david-rodriguez-blanco/SENSOR_VIPV/Sensor_VIPV_V5_SD/README.md

# SENSOR VIPV_V4
Trabajo Final de Grado: "Sensor IoT para la integración de generación fotovoltaica en vehículos eléctricos": 

Versión 4 - Mejoras: 
	· Concatenación de datos (obtención de datos con una frecuencia de 1s)
	· 2 nuevos canales de Thingspeak
	· Opción para publicación de datos concatenados (concatena datos cada 1s)
	· Opción para almacenar los datos en memoria SD y no depender de la conexión WiFi

	Proyecto desarrollado por David Rodríguez Blanco - UPM - IES
