david-rodriguez-blanco/SENSOR_VIPV/Modelos3D/Sensor_Sup.stl

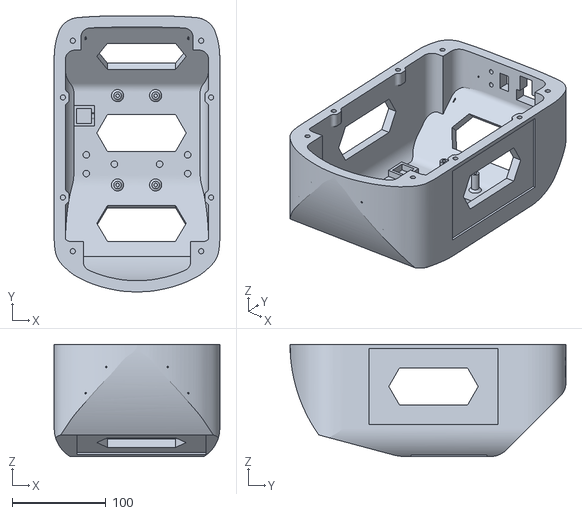
[picture p1: CAD file, 2023-07-10]
Modelos3D/Sensor_Sup.stl
177.0 x 295.0 x 120.0
