david-rodriguez-blanco/SENSOR_VIPV/Modelos3D/Sensor_Inf.stl

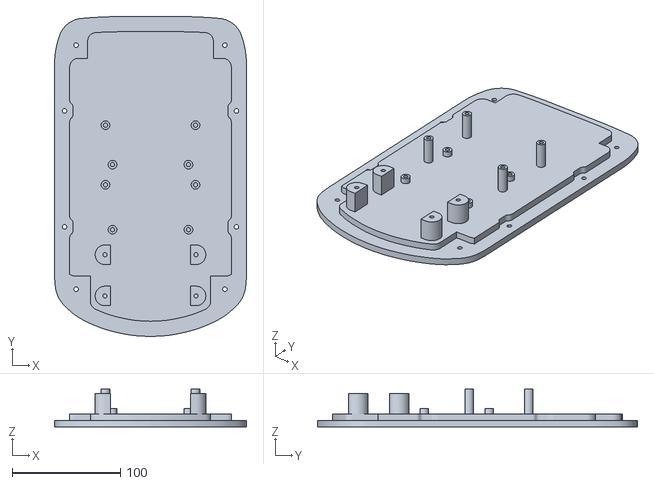
[picture p2: CAD file, 2023-07-10]
Modelos3D/Sensor_Inf.stl
177.0 x 295.0 x 35.0
