david-rodriguez-blanco/SENSOR_VIPV/Modelos3D/Sensor_Conectores.stl

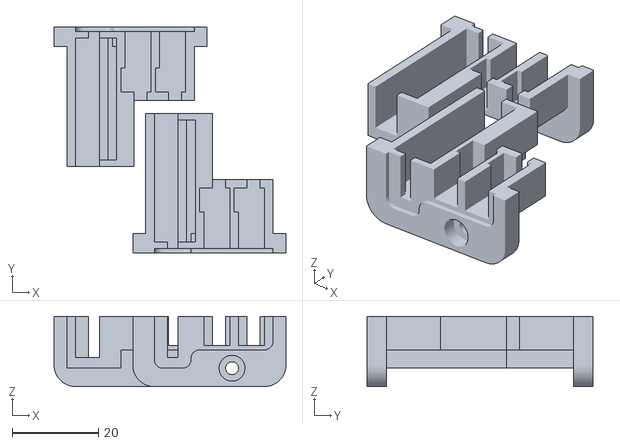
[picture p3: CAD file, 2023-07-10]
Modelos3D/Sensor_Conectores.stl
53.8 x 52.3 x 16.2
