david-rodriguez-blanco/SENSOR_VIPV/ManualVIPV.docx

MANUAL - SENSOR VIPV

David Rodríguez Blanco

Instituto Energía Solar – Febrero/2023

# SOFWARE NECESARIO

Con el fin de poder modificar, ejecutar y visualizar en tiempo real dicha ejecución, se requiere la instalación de dos programas

## STM32 CUBE IDE

Gracias a este se pueden importar y modificar el código en función de nuestras necesidades, realizar actualizaciones o incorporar nuevas funciones.

A continuación se detallan los pasos necesarios para su instalación en el caso de ser necesario.

1. Dirigirse al siguiente enlace: https://www.st.com/en/development-tools/stm32cubeide.html
2. Pinchar en “Get Software”.
3. Seleccionar “Get latest” en la correspondiente versión, en función de las características del equipo utilizado.

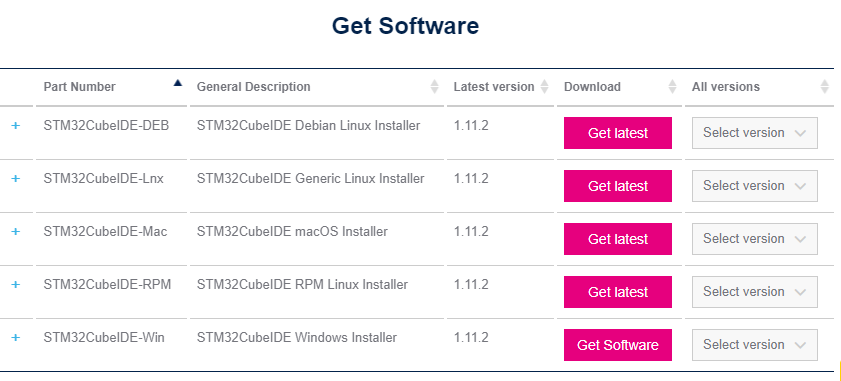
[picture p4: figure]
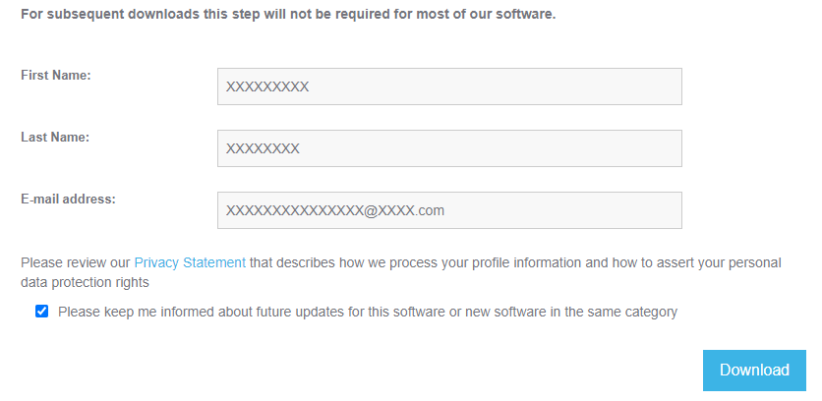
[picture p5: figure]

4. Aceptar los términos e iniciar sesión con nuestra cuenta o nombre y correo electrónico en su defecto.
5. Una vez se rellenan todos los campos pinchar en “download”.
6. Dirigirse al correo, donde se recibirá la confirmación de registro y el enlace correspondiente para su descarga.

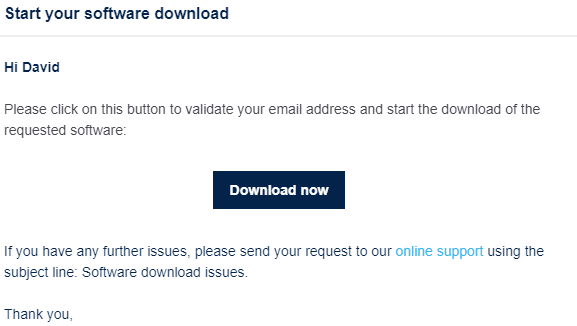
[picture p6: figure]

7. Finalmente, seguir los pasos del instalador.

## TERA TERM

Este software proporciona la terminal necesaria para visualizar en tiempo real la ejecución del programa. Resulta especialmente útil para depurar el código, detectar errores, corregirlos y verificar el correcto funcionamiento del programa.

Al igual que en el anterior, se detallan a continuación los pasos necesarios para su instalación y configuración:

1. Dirigirse al siguiente enlace: https://tera-term.softonic.com/
2. Pinchar en “descargar gratis”

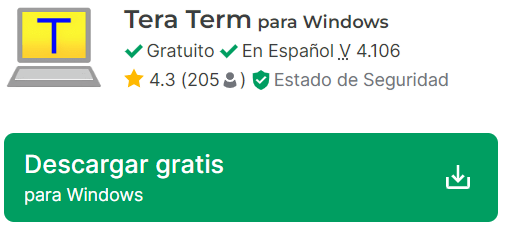
[picture p7: figure]

3. Cerrar publicidad y pinchar en “descargar gratis para PC”

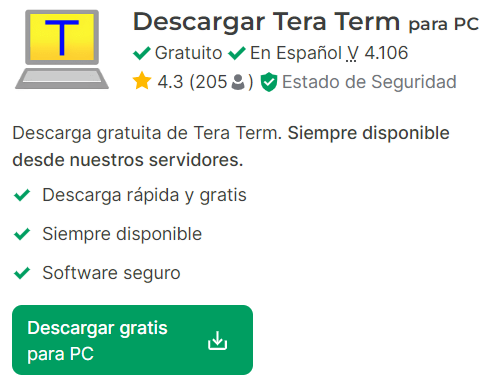
[picture p8: figure]

4. Ejecutar el instalador (.exe) que se ha descargado.

Para la correcta visualización del programa a través de la terminal es necesario modificar ciertos parámetros dentro del programa.

1. Conectar mediante un cable USB la placa al PC. El terminal correspondiente a la placa debe conectarse en el puerto identificado como “USB STLINK”.

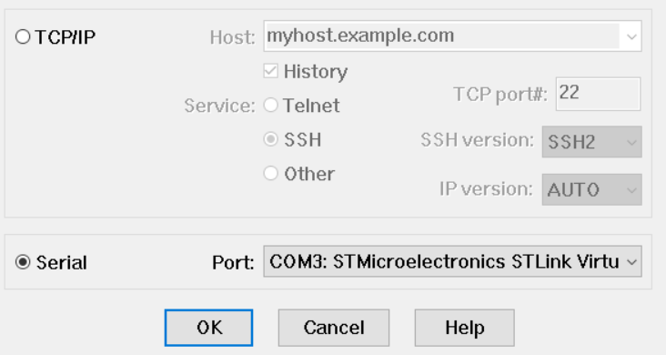
[picture p9: figure]

2. Una vez está conectado abrir el Tera Term. Debe de aparecer una ventana como la mostrada a continuación:
3. Seleccionar la opción “serial”, indicando además el puerto correspondiente a la placa en el caso de tener varios disponibles. Una vez seleccionado marcar “OK”.
4. Una vez dentro la terminal, en la barra superior, dirigirse a “Setup” -> “Terminal”, estableciendo el “New-line, Receive” como “AUTO”. Pinchar en “OK” para salir.

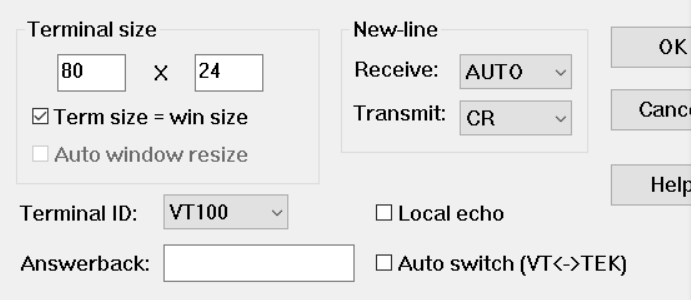
[picture p10: figure]

5. Nuevamente, desde la opción “Setup” ir a “Serial port”. Aquí, establecer los valores que se observan en la siguiente imagen:

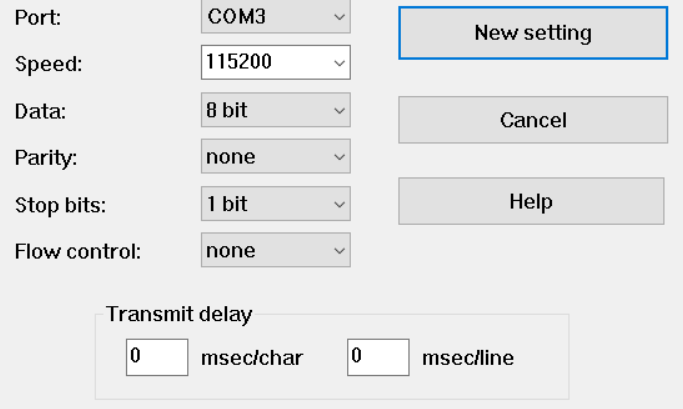
[picture p11: figure]

Seleccionar “New setting” para aceptar y salir de la pantalla.

Una vez todos estos pasos se han realizado, la terminal estará lista para mostrar los datos cuando comience la ejecución del programa.

# DESCARGA Y PUESTA EN MARCHA DEL PROGRAMA

1. Dirigirse al siguiente enlace de GitHub: https://github.com/SerPipeVera/TFG-Sensor_IoT_VIPV
2. Pinchamos en “Code” y seguidamente en “Download ZIP”.

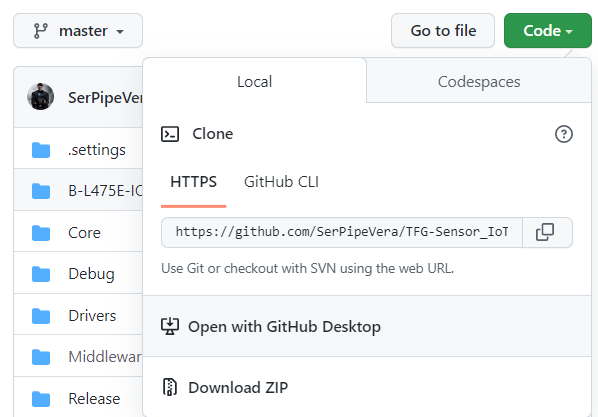
[picture p12: figure]

3. Una vez descargado el ZIP, extraer en la ubicación deseada del equipo.

Quedará una estructura como la mostrada a continuación:

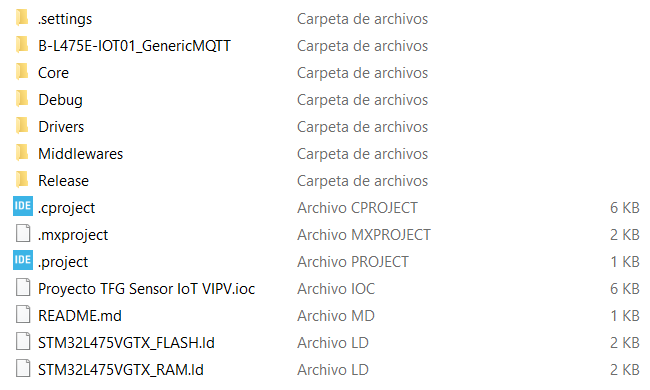
[picture p13: figure]

4. Para iniciar el programa pinchamos en el archivo “.project”.

NOTA: Si es la primera vez que se utiliza el programa, es posible que nos pida que se seleccione un workspace al que se importará el programa. Si ocurre, seleccionar las opciones por defecto.

NOTA: También se puede dar el caso de que no se disponga de las librerías necesarias para el correcto funcionamiento del programa. De darse la situación, en algún momento del proceso pedirá autorización para instalarlas, aceptar.

NOTA: A la hora de abrir el programa, debido a que fue realizado con una versión anterior a la actual, saltará el aviso, dando la opción de migrarlo. Seleccionar la opción de “migrate”.

5. Una vez se ha abierto el STM32 CUBE IDE, hay que hacer ciertos cambios obligatorios para poner en marcha el sensor. Estos se detallan en la siguiente sección.

# MODIFICACIONES NECESARIAS EN EL CÓDIGO y THINGSPEAK

Como se ha mencionado anteriormente, es necesario realizar ciertas modificaciones en el código, al igual que será necesaria la creación de dos canales de ThingSpeak.

## THINGSPEAK

Este es un servicio en la nube, necesario para almacenar los datos que captura el sensor. Deberemos de iniciar sesión y crear dos canales específicos. Los detalles se muestran a continuación:

1. Dirigirse al siguiente enlace: https://thingspeak.com/login?skipSSOCheck=true
2. Iniciar sesión con la cuenta propia de MathWorks. En el caso de no disponer de una, debe crearse.
3. Una vez dentro se deben crear los dos canales. En la pestaña “Channels” seleccionar “New Channel”.
4. Poner un nombre al canal, y rellenar los campos denominados “Field”.
  a. Para el caso del canal 1:
    i. Field 1: Irradiancia superior
    ii. Field 2: Irradiancia frontal
    iii. Field 3: Irradiancia trasera
    iv. Field 4: Irradiancia Derecha
    v. Field 5: Irradiancia Izquierda
    vi. Field 6: Temperatura
    vii. Field 7: Presión Atmosférica
    viii. Field 8: Humedad
  b. Para el caso del canal 2:
    i. Field 1: Latitud Geográfica
    ii. Field 2: Longitud Geográfica
    iii. Field 3: Altitud geográfica
    iv. Field 4: Velocidad
    v. Field 5: Inclinación Alabeo
    vi. Field 6: Inclinación Cabeceo
    vii. Field 7: Orientación geográfica

Únicamente es necesario rellenar estos campos. Cuando esta tarea se haya completado, pinchar en “Save Channel”.

5. Es conveniente establecer los canales como públicos. Opción editable en la pestaña “Sharing” dentro de cada canal.
6. Una vez los canales se han creado, se debe crear un “MQTT device”.
7. Seleccionar “Add a new device” . Establecer el nombre deseado.
8. En la sección “Authorize channels to Access”, desplegar la pestaña y seleccionar los dos canales que se han creado anteriormente.
9. Finalmente, seleccionar “Add Device”.
10. Aparecerá una nueva ventana con las credenciales del MQTT. Copiar dichas credenciales (Client ID, Username, Password) en un documento externo, ya que serán necesarias en futuros pasos.

IMPORTANTE: en el momento que se cierre está ventana no se puede acceder de nuevo a la contraseña del dispositivo.

11. Para poder visualizar el rastreo GPS del sensor durante la ruta hay que realizar los siguientes pasos:
  a. Desde el canal 2, pinchar en “MatlabVisualization”

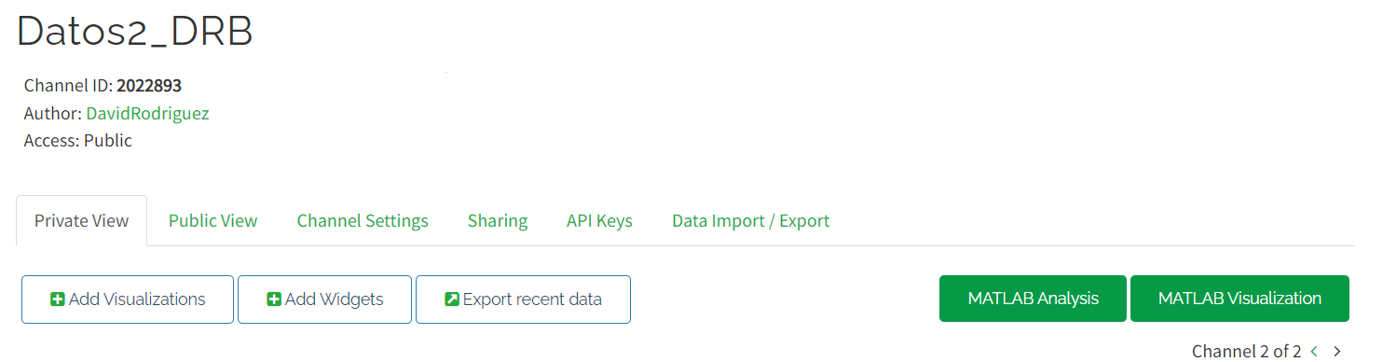
[picture p14: figure]

  b. En la opción “Templates”, seleccionar “Custom”. Seguidamente “Create”.
  c. Poner el nombre deseado e introducir el código proporcionado a continuación:

%********* Programa de representacion de los datos Geograficos del Sensor IOT ***********

clc; clear; grid off;

tipoMapa = 'streets'; %si no funciona ‘streets’, probar ‘openstreetmap’ o ‘satellite’

t_inicial = datetime(1998,05,04,20,15,15); %FORMATO: datetime(año,mes,dia,hora,min,seg)

t_final = datetime('now'); %datetime('now')

%-------------------------------------------------------------------------------------------

disp(' ************************* GeoTracking TFG Program **************************');

disp( thingSpeakRead(2022893,'Fields', [1 2],'Readkey','CLB5CP76ST7WUKL3' , ...

'DateRange', [t_inicial,t_final],'OutputFormat','TimeTable') ); %Imprime por pantalla

data = thingSpeakRead(2022893,'Fields', [1,2],'Readkey','CLB5CP76ST7WUKL3' , ...

'DateRange', [t_inicial,t_final] ); %en un intervalo temporal

Latitud = data(:,1); Longitud = data(:,2);

offset = 7.55e-5; %3.1e-5 min en valde estatico

limits_Lat = [ min(Latitud)*(1-offset) , max(Latitud)*(1+offset)];

limits_Long = [ min(Longitud)*(1+offset) , max(Longitud)*(1-offset)];

if length(Latitud) > length(Longitud) %Busca el minimo tamaño

TAM = length(Longitud);

else TAM = length(Latitud);

end

geoscatter(Latitud, Longitud, 'pb'); %grafico de dispersion por puntos, sin unir

hold on;

title('------- GeoTracking Sensor IoT VIPV -------');

for i=2:1:TAM

geoplot([Latitud(i) Latitud(i-1)],[Longitud(i) Longitud(i-1)],'r--','LineWidth',1.5);

hold on;

end

disp(' *** Mostrando información en Mapa en el siguiente Plot ***');

geolimits(limits_Lat,limits_Long); %geolimits('auto')

geobasemap( tipoMapa );

NOTA: Modificar los siguientes comandos introduciendo el ID del canal 2, así como su “Write Key”

disp( thingSpeakRead(XXXXXXX,'Fields', [1 2],'Readkey','XXXXXXXXXXXXX' , ...

data = thingSpeakRead(XXXXXXX,'Fields', [1,2],'Readkey', 'XXXXXXXXXXXXX'

12. Finalmente, en “Display Settings” seleccionar el canal 2.

## CÓDIGO

En el código se encuentran ciertos parámetros a modificar. De igual manera, se recomienda leer la bibliografía aportada por el autor del programa (GitHub) para comprender el código y sus funciones.

En relación con la configuración, son varios los parámetros que se tienen que modificar para poder hacer uso al completo del sensor.

### CONEXIÓN WIFI

Es necesario establecer el teléfono móvil como punto de acceso obteniendo del mismo los siguientes parámetros:

Estas líneas de código se localizan en el fichero “main.h”, y deberán modificarse en relación con el punto de acceso utilizado.

### CONEXIÓN THINSPEAK

De igual manera, se deben modificar los siguientes parámetros para poder conectarse con los canales de ThingSpeak creados anteriormente.

#define CREDENCIALES_SERV_IOT "HostName=mqtt3.thingspeak.com;HostPort=1883;ConnSecurity=0;MQClientId=BR4EMRE6FSArEg8uAQcGNz0;MQUserName=BR4EMRE6FSArEg8uAQcGNz0;MQUserPwd=iB2Ll9XEzKF/oqYOuLZLA9zv;"

Los parámetros “HostName”, “HostPort” y “ConnSecurity” permanecen constantes.

En los siguientes, colocar las credenciales obtenidas en el momento de crear el MQTT Device.

NOTA: En el caso de errores en la ejecución, verificar en la documentación de MatLab si el “HostName” es el correcto o se ha actualizado.

Enlace de interés para solucionar problemas: https://es.mathworks.com/help/thingspeak/troubleshoot-MQTT-publish.html

Finalmente, modificar:

Los números “2022892” y “2022893” corresponden a los identificadores de los canales de ThingSpeak.

# HARDWARE

A continuación, se adjunta un esquema eléctrico que puede resultar de gran utilidad en el caso de fallo en las conexiones o rediseño del sensor.

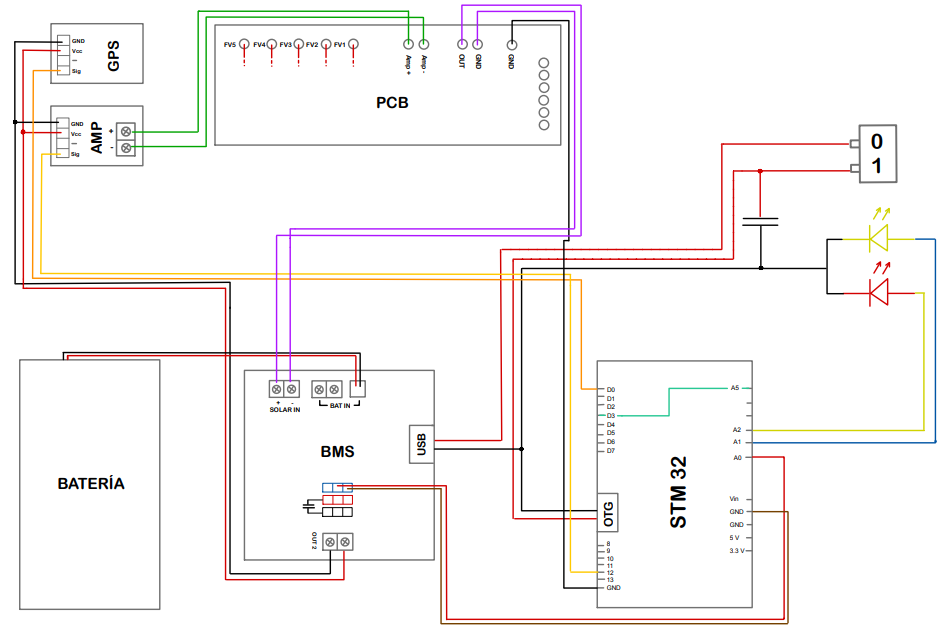
[picture p15: figure]

## HARDWARE UPDATE

Con el fin de hacer más robusto el sensor y evitar fallos, se ha modificado todo el cableado interno. El esquema mostrado en la parte superior continúa siendo el mismo, pero replicado sobre una pcb e incorporando conectores para hacer más fácil su reparación o desmontaje.

A continuación, se detallan los esquemas de los distintos componentes. No obstante, todos los cables han sido etiquetados para evitar confusiones.

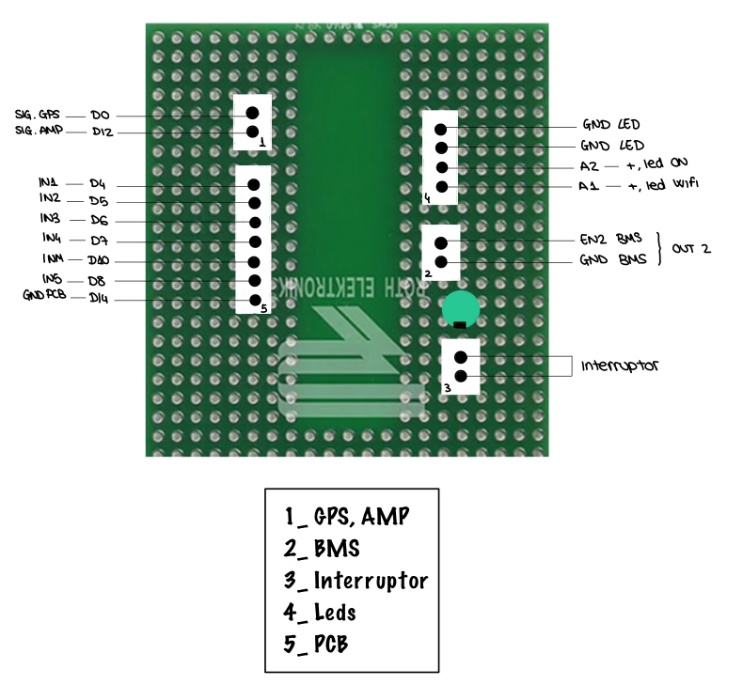
[picture p16: figure]
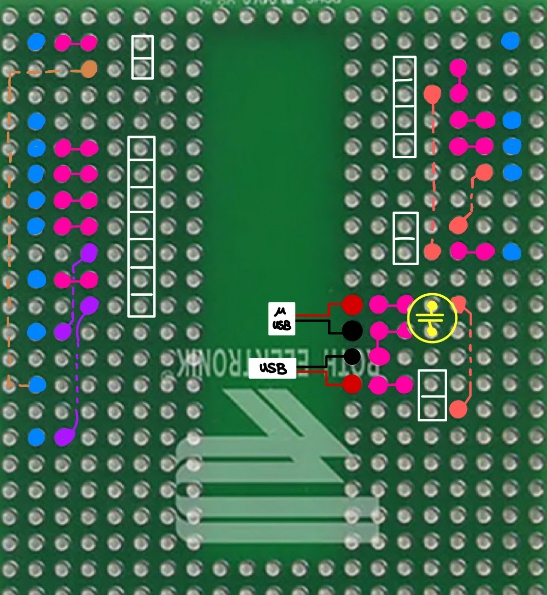
[picture p17: figure]

# SOTWARE UPDATE

Con el fin de mejorar el funcionamiento del sensor, se han realizado una serie de modificaciones que se detallarán a continuación.

El principal objetivo de estas era incidir lo mínimo posible en el funcionamiento original del sensor, por lo que se han diseñado funciones completamente independientes y con la capacidad de ser desactivadas de forma sencilla, consiguiendo así volver al estado original sin complicaciones.

Estas modificaciones han sido realizadas con el fin de obtener un mayor número de muestras, reduciendo notablemente la incertidumbre.

En un principio, el software realizaba medidas con un periodo de 1 segundo, para posteriormente, a los 60 segundos, hacer una media y enviarla a la nube. A la vista de esto, nos resulto útil intentar obtener esas mediciones realizadas cada segundo, ya que serían de gran utilidad principalmente a la hora de garantizar una buena ubicación GPS.

Debido a las limitaciones del servidor de Thingspeak, es imposible enviar los datos de forma inmediata, por lo que la solución adoptada fue concatenar las medidas durante cierto tiempo, para después enviarlas en conjunto.

Para no saturar la memoria de nuestro micro, se ha reducido el tiempo de envío de datos a 10 segundos.

## MODIFICACIONES EN EL CÓDIGO

En primer lugar, ha sido necesario crear un nuevo tipo de dato. En el código anterior disponíamos de un tipo de dato que almacenaba las medidas en forma de “float”, pero esto no nos era de utilidad, ya que para concatenarlos es necesario hacerlo en forma de “string”.

La nueva estructura se muestra a continuación, definida en “sensor_data.h”:

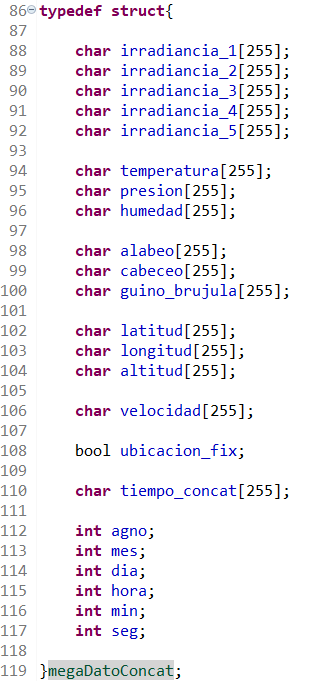
[picture p18: figure]

Una vez la estructura ha sido creada, el siguiente objetivo es concatenar las medidas.

Para esto, se ha utilizado el mismo vector de muestras que se emplea para hacer la media original (“vectorLecturas”), de forma que la media será exactamente la de los datos concatenados.

Para concatenarlos, primero debemos de convertir el dato que nos llega como “float” a “string”. Una vez la conversión ha sido hecha, concatenamos el dato, junto con un elemento conocido para separar las muestras. Se repite el proceso para todas las medidas tomadas.

Si se quieren más detalles, el código se encuentra comentado en el archivo .c .

Este proceso se encuentra en la función “calcula_concatenar(megaDatoConcat* datosConcat, megaDato* p_vectorLecturas, uint8_t n_elem)” dentro de “ApploT_TFG_VIPV.c”.

Con los datos concatenados y almacenados en la variable correspondiente, procedemos a su envío al servidor de thinskpeak.

El método es idéntico al realizado por el código original para los canales 1 y 2, salvo que replicándolo sobre unos nuevos canales 3 y 4. De esta manera garantizamos no pisar los datos originales, pudiendo a la vez contrastar la media con los datos concatenados.

Esto se encuentra en “publica_DatosConcatThingSpeak(megaDatoConcat*miDatoConcat)” dentro de “ApploT_TFG_VIPV.c”.

## RECUPERACIÓN DEL CÓDIGO INICIAL

Como se ha mencionado con anterioridad, es muy sencillo volver a las funcionalidades originales. Únicamente son necesarios un par de sencillos pasos para lograrlo:

1. Cambiar los tiempos de envío de datos.

En ““ApploT_TFG_VIPV.h” encontraremos las siguientes líneas de código:

Los valores mostrados en la imagen son los adecuados para ejecutar el código con el modo concatenar activo, para recuperar el funcionamiento original se debe establecer el periodo de publicación de datos a 60 segundos, y el periodo de recuperación de datos a 30 segundos.

2. Comentar la declaración de las funciones.

Para facilitar este proceso, en el “ApploT_TFG_VIPV.h” se ha definido una línea específica:

Solo hará falta comentar la línea 37 para desactivar tanto la función de concatenar como la de envío de datos concatenados.

## ¿QUÉ PASA SI SE PIERDE LA CONEXIÓN?

En el código original, si se pierde la conexión los datos comienzan a almacenarse en una FIFO, para posteriormente ser enviados cuando la conexión sea restablecida. Está función no ha sido modificada, de manera que los datos correspondientes a la media, los que se envían al canal 1 y 2, se seguirán almacenando y recuperando de acuerdo al funcionamiento normal.

Sin embargo, con los datos concatenados no se ha podido hacer lo mismo. Debido a que estos datos ocupan una cantidad considerablemente mayor de memoria, en el caso de que se pierda la conexión se dejaran de enviar, reiniciándose cada 10 segundos. Así, en el preciso instante que se recupere la conexión, los datos concatenados volverán a enviarse.

Para poder realizar esta función, se han incluido algunas líneas dentro de la función “ApploT_TFG_VIPV.c” :

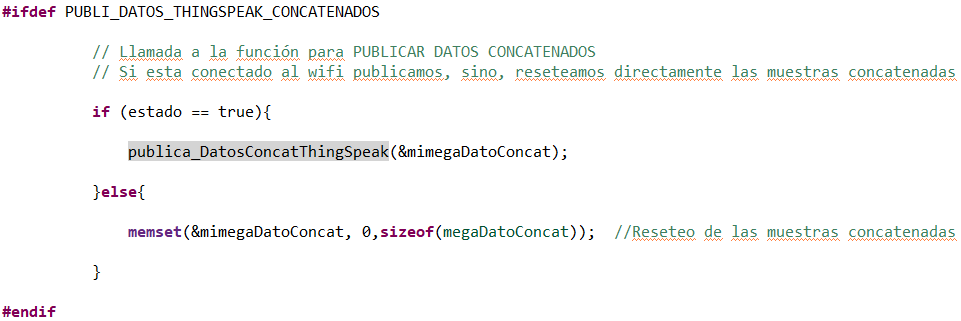
[picture p19: figure]

De esta manera, tras concatenar los datos, si el Wifi se encuentra conectado se realiza la llamada a la función encargada de publicarlos; en cambio, si el Wifi esta desconectado, se resetean de forma inmediata.

## MEMORIA SD

Con el objetivo de no depender de la conexión WiFi proporcionada por el móvil, se ha añadido una memoria externa (microSD) mediante el puerto PMOD de la STM32.

HARDWARE

Conectar el módulo PMOD en el puerto correspondiente de la placa, o mediante el alargador que lo hace accesible desde el exterior de la carcasa.

SOWFTWARE

Siguiendo con la dinámica del código original, se ha incluido una definición al inicio del programa con el objetivo de poder seleccionar entre un modo u otro:

Seleccionando el modo correspondiente se ejecutarán las funciones necesarias para la utilización de la SD. Estas son:

- Inicializa_SD(): encargada de montar la SD, obtener algunas variables como el espacio total y el disponible, obtener la fecha y hora para dar nombre al fichero de datos, y finalmente crear dicho fichero de datos.
- Escribir_fichero(…): encargada de escribir en el fichero los datos pasados como parámetro. Recibe el nombre del fichero donde escribir y los datos a escribir.
- Obencion_dato_SD(): obtiene los datos medidos por el sensor y los concatena generando un string. Este será posteriormente pasado a la función “escribir_fichero” con el fin de reflejarlo en el fichero creado en la SD.

# MODO DE USO CON LA VERSIÓN FINAL

A continuación, se detallan los pasos a seguir para utilizar el sensor con su ultima versión, tanto de software como de hardware.

## HARDWARE

Se han incluido conectores externos con el fin de hacer totalmente accesible el sensor desde el exterior, sin necesidad de desmontarlo de la placa metálica para nada.

En la parte trasera, junto al interruptor de encendido y apagado, se encuentra la tarjeta SD junto con dos conectores USB. El conector superior es el encargado de la transmisión de datos, y lo utilizaremos en el caso de que se quiera modificar la programación del microcontrolador.

En la parte inferior se encuentra el de carga (el estado de la carga se puede ver a través de un pequeño orificio situado en la carcasa).

Ambos conectores se conectan al ordenador a través del cable USB fabricado específicamente para la ocasión.

## SOFTWARE

Después de las últimas modificaciones, el sensor almacena los datos en la tarjeta SD, generando un fichero, cuyo nombre es la fecha y hora en el momento que empieza la medición.

Antes de encender el sensor se debe de preparar el acceso de Wifi. El sensor necesita conectarse a un Wifi al inicio para poder obtener la fecha y hora actual.

El móvil que genera le Wifi debe configurarse con los siguientes parámetros:

Nombre del punto de Acceso: SensorIoT

Contraseña: SensorIoT

Configurando el punto de acceso como se menciona, y encendiéndolo antes de encender el sensor, debería de conectarse sin problemas.

Una vez el sensor se ha conectado satisfactoriamente, la luz azul del mismo se encenderá de forma fija, señalizando que esta obteniendo la fecha y hora.

En el momento que el led azul comience a parpadear significará que está almacenando los datos de forma correcta en la tarjeta SD, momento en el cual podremos desactivar el punto de acceso sin problema, ya que el sensor no lo necesita más en ningún momento de la medición.
