david-rodriguez-blanco/SENSOR_VIPV/Sensor_VIPV_V5_SD/Core/Src/main.c

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
/* Includes ------------------------------------------------------------------*/
#include "main.h"
#include "fatfs.h"

/* USER CODE BEGIN PM */
// --------VARIABLES GLOBALES UTILIZADAS-----------
uint32_t ADC1_buffer = 0 ;	//variable a almacenar el nivel del ADC por DMA

size_t old_pos =0, pos=0;	//las posiciones del buffer circular NMEA

static volatile uint8_t button_flags = 0;	//para controlar botón de usuario con interrupciones

char buffc_DMA_UART[TAM_BUFNMEA] ={'\0'};	//Buffer para almacenar cadenas entrantes de UART por DMA

//volatile float beta = 0.5f;				// algorithm gain
//volatile float q0=0.0f, q1=0.0f, q2=0.0f, q3=0.0f;	// quaternion of sensor frame relative to auxiliary frame

/* USER CODE END PM */

ADC_HandleTypeDef hadc1;
DMA_HandleTypeDef hdma_adc1;

CRC_HandleTypeDef hcrc;

I2C_HandleTypeDef hi2c2;

LPTIM_HandleTypeDef hlptim1;
LPTIM_HandleTypeDef hlptim2;

OPAMP_HandleTypeDef hopamp2;

RNG_HandleTypeDef hrng;

RTC_HandleTypeDef hrtc;

SPI_HandleTypeDef hspi2;
SPI_HandleTypeDef hspi3;

TIM_HandleTypeDef htim3;
TIM_HandleTypeDef htim6;

UART_HandleTypeDef huart4;
UART_HandleTypeDef huart1;
DMA_HandleTypeDef hdma_uart4_rx;

/* USER CODE BEGIN PV */
net_hnd_t         hnet; /* Es inicializado porcloud_main(). */
/* USER CODE END PV */

void SystemClock_Config(void);
void PeriphCommonClock_Config(void);
static void MX_GPIO_Init(void);
static void MX_DMA_Init(void);
static void MX_ADC1_Init(void);
static void MX_UART4_Init(void);
static void MX_TIM3_Init(void);
static void MX_USART1_UART_Init(void);
static void MX_I2C2_Init(void);
static void MX_RNG_Init(void);
static void MX_RTC_Init(void);
static void MX_SPI3_Init(void);
static void MX_OPAMP2_Init(void);
static void MX_LPTIM1_Init(void);
static void MX_LPTIM2_Init(void);
static void MX_CRC_Init(void);
static void MX_TIM6_Init(void);
static void MX_SPI2_Init(void);
/* USER CODE BEGIN PFP */
void SPI_WIFI_ISR(void);
static void Button_ISR(void);
static void conexion_IoT(void);

/* USER CODE END PFP */

/**
  * @brief  The application entry point.
  * @retval int
  */
int main(void)
{
  /* MCU Configuration--------------------------------------------------------*/

  /* Reset of all peripherals, Initializes the Flash interface and the Systick. */
  HAL_Init();

  /* Configure the system clock */
  SystemClock_Config();

/* Configure the peripherals common clocks */
  PeriphCommonClock_Config();

  /* USER CODE BEGIN SysInit */
  BSP_LED_Init(LED_GREEN);	//Led de usuario en la placa
  BSP_PB_Init(BUTTON_USER, BUTTON_MODE_EXTI);	//PushButton de la placa
  /* USER CODE END SysInit */

  /* Initialize all configured peripherals */
  MX_GPIO_Init();
  MX_DMA_Init();
  MX_ADC1_Init();
  MX_UART4_Init();
  MX_TIM3_Init();
  MX_USART1_UART_Init();
  MX_I2C2_Init();
  MX_RNG_Init();
  MX_RTC_Init();
  MX_SPI3_Init();
  MX_OPAMP2_Init();
  MX_LPTIM1_Init();
  MX_LPTIM2_Init();
  MX_CRC_Init();
  MX_TIM6_Init();
  MX_SPI2_Init();
  MX_FATFS_Init();
  /* USER CODE BEGIN 2 */

  if( HAL_OK != init_sensors() )
  {
	  Error_Handler();
  }

 MX_MEMS_Init();

  /* Estado inicial de algunos puertos de salida*/
  HAL_GPIO_WritePin(ARD_A0_3_3CTRL_GPIO_Port, ARD_A0_3_3CTRL_Pin, GPIO_PIN_SET);
  	  	  	  	  	  	  	  /*encender alimentacion sensores a 3.3V del BMS */
  HAL_GPIO_WritePin(LED3_WIFI__LED4_BLE_GPIO_Port, LED3_WIFI__LED4_BLE_Pin, GPIO_PIN_SET );
  HAL_GPIO_WritePin(GPIOC, ARD_A1_LEDWIFI_Pin, GPIO_PIN_RESET);	//LED de conexión Wi-Fi

  HAL_GPIO_WritePin(GPIOC, ARD_A2_LEDON_Pin, GPIO_PIN_SET); //LED de programa encendido correctamente

  HAL_GPIO_WritePin(GPIOA, ARD_D4_Pin, GPIO_PIN_SET);	//Carga inicial de los módulos FV
  HAL_GPIO_WritePin(GPIOB, ARD_D5_Pin, GPIO_PIN_SET);
  HAL_GPIO_WritePin(GPIOB, ARD_D6_Pin, GPIO_PIN_SET);
  HAL_GPIO_WritePin(GPIOA, ARD_D7_Pin, GPIO_PIN_SET);
  HAL_GPIO_WritePin(GPIOB, ARD_D8_Pin, GPIO_PIN_SET);

  HAL_GPIO_WritePin(ARD_D10_MFT_GPIO_Port, ARD_D10_MFT_Pin, GPIO_PIN_RESET); //Apagado interruptor de medida

  printf("\x1b[2J" "\x1b[f"); //limpiar buffer y ventana de TeraTerm

  printf("\n\n\n\n\n");
  printf("#############################################################################################\n"
		 "#######									SENSOR VIPV									#######\n"
         "#######							Continuacion TFG Sergio Vera						#######\n"
         "#######		Sensor IoT para la integracion fotovoltaica en vehiculos electricos		#######\n"
         "#######		Universidad Politecnica de Madrid - ETSIDI - Instituto de Energia Solar	#######\n"
         "#######								Madrid - mayo de 2023							#######\n"
		 "#######																				#######\n"
		 "#######							** VERSION 5 - MEMORIA SD **						#######\n"
         "#############################################################################################\n");
  printf("\n\n");


  conexion_IoT();		/*Entra en las funciones de conexion a internet y configuracion dispositivo IoT.
  	  	  	  	  	  	 * Una vez en ellas, entra en un bucle infinito de recabar datos y publicarlos
  	  	  	  	  	  	  */

  HAL_NVIC_SystemReset(); //en caso de salida del bucle principal, reinicia el programa enetero


  /* USER CODE END 2 */

  /* Infinite loop */
  /* USER CODE BEGIN WHILE */

  while (1)
  {
    /* USER CODE END WHILE */

    /* USER CODE BEGIN 3 */
  }
  /* USER CODE END 3 */
}

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
/* USER CODE BEGIN 4 */
void HAL_ADC_Conv_CpltCallback(ADC_HandleTypeDef* hadc)
{
	if (HAL_OK != HAL_ADC_Stop_DMA(&hadc1))
		Error_Handler();
}

/**********************Funciones para habilitar el envío de mensajes por el USART1 al COM del ordenador*********
 * **********************************************************************************************************
 */
#if (defined(__GNUC__) && !defined(__CC_ARM))
#define PUTCHAR_PROTOTYPE int __io_putchar(int ch)
#define GETCHAR_PROTOTYPE int __io_getchar(void)
#else
#define PUTCHAR_PROTOTYPE int fputc(int ch, FILE *f)
#define GETCHAR_PROTOTYPE int fgetc(FILE *f)
#endif /* __GNUC__ */

/**
  * @brief  Retargets the C library printf function to the USART.
  * @param  None
  * @retval None
  */
PUTCHAR_PROTOTYPE
{
  /* Place your implementation of fputc here */
  /* e.g. write a character to the USART2 and Loop until the end of transmission */
  while (HAL_OK != HAL_UART_Transmit(&huart1, (uint8_t *) &ch, 1, 30000))
  {
    ;
  }
  return ch;
}

/**
  * @brief  Retargets the C library scanf function to the USART.
  * @param  None
  * @retval None
  */
GETCHAR_PROTOTYPE
{
  /* Place your implementation of fgetc here */
  /* e.g. read a character on USART and loop until the end of read */
  uint8_t ch = 0;
  while (HAL_OK != HAL_UART_Receive(&huart1, (uint8_t *)&ch, 1, 30000))
  {
    ;
  }
  return ch;
}

/**
  * @brief  Interrupción llamada por DMA del UART4 al sobrepasar la mitad del buffer del DMA
  * Su función es actualizar los punteros para acotar el mensaje y no permitir condiciones de carrera
  * @param  None
  * @retval None
  */
void HAL_UART_RxHalfCpltCallback(UART_HandleTypeDef *huart)  //funciones de Callback de las interrupciones
{
	old_pos = pos;
	while( HAL_OK != UART_CheckIdleState(&huart4) );
		//mientras no está ocioso, esperamos un poco para evitar condiciones de carrera
	pos= TAM_BUFNMEA - (huart4.hdmarx->Instance->CNDTR);
}

/**
  * @brief  Interrupción llamada por DMA del UART4 al sobrepasar por completo el buffer del DMA
  * Su función es actualizar los punteros para acotar el mensaje y no permitir condiciones de carrera
  * @param  None
  * @retval None
  */
void HAL_UART_RxCpltCallback(UART_HandleTypeDef *huart)
{
	old_pos = pos;
	while( HAL_OK != UART_CheckIdleState(&huart4) );
		//mientras no está ocioso, esperamos un poco para evitar condiciones de carrera
	pos= TAM_BUFNMEA - (huart4.hdmarx->Instance->CNDTR);
}

/**
  * @brief  Llamada a función extern que implementa la aplicación IoT de lectura-publicación datos
  * @param  None
  * @retval None
  */
static void conexion_IoT( void )
{
  aplicacion_ClienteMQTT_XCLD_IoT();
}


/**
  * @brief Update button ISR status
  */
static void Button_ISR(void)
{
  button_flags++;
}

/**
  * @brief Obtiene el numero de veces que se ha pulsado el boton de usuario
  */
uint8_t Boton_GetNumPush(void)
{

  if (button_flags > 1)
  {
    button_flags = 0;
    return BP_MULTIPLE_PUSH;
  }

  if (button_flags == 1)
  {
    button_flags = 0;
    return BP_SINGLE_PUSH;
  }
  return BP_NOT_PUSHED;
}


void HAL_GPIO_EXTI_Callback(uint16_t GPIO_Pin)
{
  switch (GPIO_Pin)
  {
    case (GPIO_PIN_13):
    {
      Button_ISR();
      break;
    }

	case (GPIO_PIN_1):
	{
		SPI_WIFI_ISR();
		break;
	}

    default:
    {
      break;
    }
  }
}


/* USER CODE END 4 */
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
