david-rodriguez-blanco/SENSOR_VIPV/Sensor_VIPV_V5_SD/B-L475E-IOT01_GenericMQTT/Application/Common/sensors_data.h

/**
  ******************************************************************************
  * @file    sensors_data.h
  * @author  MCD Application Team
  * @brief   Header for configuration
  ******************************************************************************
  * @attention
  *
  * <h2><center>&copy; Copyright (c) 2017 STMicroelectronics International N.V. 
  * All rights reserved.</center></h2>
  *
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
  ******************************************************************************
  */

/* Define to prevent recursive inclusion -------------------------------------*/

#include <stdbool.h>

#ifndef __sensors_data_h
#define __sensors_data_h
#ifdef __cplusplus
 extern "C" {
#endif

int init_sensors(void);
int PrepareSensorsData(char * Buffer, int Size, char * deviceID);

/*--------Estructura de todos los datos de una medición------------------------*/
typedef struct{

	float temperatura;
	float irradiancia[5];
	float presion;
	float humedad;

	float alebeo;
	float cabeceo;
	float guino_brujula;

	float latitud;
	float longitud;
	float altitud;
	float velocidad;
	bool ubicacion_fix;

	int agno;
	int mes;
	int dia;
	int hora;
	int min;
	int seg;

}megaDato;

typedef struct{

	char irradiancia_1[255];
	char irradiancia_2[255];
	char irradiancia_3[255];
	char irradiancia_4[255];
	char irradiancia_5[255];

	char temperatura[255];
	char presion[255];
	char humedad[255];

	char alabeo[255];
	char cabeceo[255];
	char guino_brujula[255];

	char latitud[255];
	char longitud[255];
	char altitud[255];

	char velocidad[255];

	bool ubicacion_fix;

	char tiempo_concat[255]; 				// Concatenación de una fecha, junto con la sucesión de horas

	int agno;
	int mes;
	int dia;
	int hora;
	int min;
	int seg;

}megaDatoConcat;


#ifdef __cplusplus
}
#endif
#endif /* __sensors_data_h */

/************************ (C) COPYRIGHT STMicroelectronics *****END OF FILE****/
