david-rodriguez-blanco/SENSOR_VIPV/(commit log)

2023-06-12 Manual Sensor_VIPV
2023-07-10 Modelos 3D
    [Sensor_Conectores.stl, Sensor_Inf.stl, Sensor_Sup.stl]
